escolero/MONITOR_APNEA/(list of files, drawings)

Other design files:
Frecuencia Respiratoria.pdsprj
